samarthamp/Efficient_CLA_Adder/Magic/integrated_CLA_layout.spice

* SPICE3 file created from xor_v2_layout.ext - technology: scmos

.include TSMC_180nm.txt
.param vdd=1.8
.param LAMBDA=0.09u
.global vdd gnd
.option scale=0.09u

M1000 a_n100_n630# clk a_n100_n599# w_n113_n605# CMOSP w=40 l=2
+  ad=200 pd=90 as=320 ps=96
M1001 a_218_n321# clk a_196_n324# Gnd CMOSN w=20 l=2
+  ad=160 pd=56 as=100 ps=50
M1002 vdd a_205_n771# S2 w_225_n782# CMOSP w=20 l=2
+  ad=19200 pd=9170 as=100 ps=50
M1003 a_n44_n457# clk a_n44_n425# Gnd CMOSN w=20 l=2
+  ad=100 pd=50 as=160 ps=56
M1004 a_812_n333# a_754_n266# vdd w_743_n339# CMOSP w=20 l=2
+  ad=100 pd=50 as=0 ps=0
M1005 a_202_n456# A1_after vdd w_196_n469# CMOSP w=20 l=2
+  ad=100 pd=50 as=0 ps=0
M1006 a_576_n331# clk a_608_n304# w_569_n310# CMOSP w=40 l=2
+  ad=200 pd=90 as=320 ps=96
M1007 vdd a_290_n121# a_324_n129# w_318_n162# CMOSP w=40 l=2
+  ad=0 pd=0 as=320 ps=96
M1008 a_527_n409# Pout_bar a_556_n409# w_550_n422# CMOSP w=40 l=2
+  ad=200 pd=90 as=320 ps=96
M1009 vdd a_274_n792# a_262_n749# w_294_n803# CMOSP w=20 l=2
+  ad=0 pd=0 as=100 ps=50
M1010 a_n44_n599# a_n102_n532# vdd w_n113_n605# CMOSP w=20 l=2
+  ad=100 pd=50 as=0 ps=0
M1011 a_756_n364# Cout_before gnd Gnd CMOSN w=10 l=2
+  ad=60 pd=32 as=9600 ps=5350
M1012 vdd node14 a_184_n576# w_182_n587# CMOSP w=20 l=2
+  ad=0 pd=0 as=160 ps=56
M1013 gnd a_290_n121# a_293_n127# Gnd CMOSN w=10 l=2
+  ad=0 pd=0 as=60 ps=32
M1014 A1_after a_n37_n555# gnd Gnd CMOSN w=10 l=2
+  ad=50 pd=30 as=0 ps=0
M1015 a_511_n699# node23 vdd w_498_n705# CMOSP w=40 l=2
+  ad=320 pd=96 as=0 ps=0
M1016 a_39_n411# C0 gnd Gnd CMOSN w=10 l=2
+  ad=60 pd=32 as=0 ps=0
M1017 a_n106_n504# a_n100_n416# gnd Gnd CMOSN w=10 l=2
+  ad=60 pd=32 as=0 ps=0
M1018 vdd Gout_bar Cout_before w_616_n382# CMOSP w=20 l=2
+  ad=0 pd=0 as=160 ps=56
M1019 gnd a_797_n461# a_789_n425# Gnd CMOSN w=20 l=2
+  ad=0 pd=0 as=160 ps=56
M1020 a_202_n391# node11 gnd Gnd CMOSN w=10 l=2
+  ad=100 pd=60 as=0 ps=0
M1021 gnd A2_after P2_bar Gnd CMOSN w=10 l=2
+  ad=0 pd=0 as=80 ps=36
M1022 a_n102_n532# a_n106_n534# gnd Gnd CMOSN w=10 l=2
+  ad=50 pd=30 as=0 ps=0
M1023 gnd S1_before a_256_n323# Gnd CMOSN w=10 l=2
+  ad=0 pd=0 as=60 ps=32
M1024 node32 a_622_n503# gnd Gnd CMOSN w=10 l=2
+  ad=50 pd=30 as=0 ps=0
M1025 a_356_n893# a_322_n895# vdd w_350_n932# CMOSP w=40 l=2
+  ad=320 pd=96 as=0 ps=0
M1026 node32 a_622_n503# vdd w_616_n526# CMOSP w=20 l=2
+  ad=100 pd=50 as=0 ps=0
M1027 A3_after a_770_n555# vdd w_790_n566# CMOSP w=20 l=2
+  ad=200 pd=100 as=0 ps=0
M1028 a_842_n365# a_812_n333# gnd Gnd CMOSN w=20 l=2
+  ad=160 pd=56 as=0 ps=0
M1029 C1 node02 vdd w_331_n318# CMOSP w=20 l=2
+  ad=260 pd=106 as=0 ps=0
M1030 a_536_n460# node34 vdd w_570_n483# CMOSP w=20 l=2
+  ad=160 pd=56 as=0 ps=0
M1031 a_691_n653# a_633_n586# vdd w_622_n659# CMOSP w=20 l=2
+  ad=100 pd=50 as=0 ps=0
M1032 a_662_n369# node36 gnd Gnd CMOSN w=20 l=2
+  ad=160 pd=56 as=0 ps=0
M1033 a_635_n653# S3_before vdd w_622_n659# CMOSP w=40 l=2
+  ad=320 pd=96 as=0 ps=0
M1034 gnd P2_bar node24 Gnd CMOSN w=10 l=2
+  ad=0 pd=0 as=80 ps=36
M1035 a_n100_n477# B1 vdd w_n113_n483# CMOSP w=40 l=2
+  ad=320 pd=96 as=0 ps=0
M1036 vdd a_93_n615# C2 w_116_n646# CMOSP w=20 l=2
+  ad=0 pd=0 as=200 ps=100
M1037 vdd G3_bar node33 w_616_n467# CMOSP w=20 l=2
+  ad=0 pd=0 as=160 ps=56
M1038 a_122_n615# node15 a_93_n615# w_116_n646# CMOSP w=40 l=2
+  ad=320 pd=96 as=200 ps=90
M1039 vdd a_289_n151# a_289_n181# w_318_n162# CMOSP w=20 l=2
+  ad=0 pd=0 as=100 ps=50
M1040 a_292_n159# clk a_289_n181# Gnd CMOSN w=20 l=2
+  ad=160 pd=56 as=100 ps=50
M1041 node13 G1_bar vdd w_136_n587# CMOSP w=20 l=2
+  ad=160 pd=56 as=0 ps=0
M1042 G1_bar B1_after a_55_n540# Gnd CMOSN w=20 l=2
+  ad=100 pd=50 as=160 ps=56
M1043 gnd node01 a_326_n523# Gnd CMOSN w=10 l=2
+  ad=0 pd=0 as=100 ps=60
M1044 a_638_n284# a_580_n336# vdd w_569_n310# CMOSP w=20 l=2
+  ad=100 pd=50 as=0 ps=0
M1045 a_886_n355# Cout vdd w_873_n339# CMOSP w=20 l=2
+  ad=100 pd=50 as=0 ps=0
M1046 vdd a_93_n515# node12 w_116_n546# CMOSP w=20 l=2
+  ad=0 pd=0 as=100 ps=50
M1047 a_411_n699# P2_bar vdd w_398_n705# CMOSP w=40 l=2
+  ad=320 pd=96 as=0 ps=0
M1048 a_122_n515# G0_bar a_93_n515# w_116_n546# CMOSP w=40 l=2
+  ad=320 pd=96 as=200 ps=90
M1049 a_102_n336# a_95_n380# vdd w_112_n386# CMOSP w=20 l=2
+  ad=100 pd=50 as=0 ps=0
M1050 gnd a_415_n135# a_499_n159# Gnd CMOSN w=20 l=2
+  ad=0 pd=0 as=160 ps=56
M1051 a_662_n454# node32 gnd Gnd CMOSN w=20 l=2
+  ad=160 pd=56 as=0 ps=0
M1052 B2_after a_324_n823# vdd w_389_n858# CMOSP w=20 l=2
+  ad=200 pd=100 as=0 ps=0
M1053 vdd a_n106_n504# a_n102_n509# w_n108_n515# CMOSP w=20 l=2
+  ad=0 pd=0 as=100 ps=50
M1054 vdd a_415_n135# a_463_n181# w_441_n146# CMOSP w=20 l=2
+  ad=0 pd=0 as=100 ps=50
M1055 a_789_n631# clk a_770_n555# Gnd CMOSN w=20 l=2
+  ad=160 pd=56 as=100 ps=50
M1056 a_475_n895# A2 gnd Gnd CMOSN w=10 l=2
+  ad=60 pd=32 as=0 ps=0
M1057 a_39_n380# C0 vdd w_26_n386# CMOSP w=40 l=2
+  ad=320 pd=96 as=0 ps=0
M1058 gnd node21 a_183_n634# Gnd CMOSN w=10 l=2
+  ad=0 pd=0 as=100 ps=60
M1059 a_712_n284# S0 gnd Gnd CMOSN w=10 l=2
+  ad=50 pd=30 as=0 ps=0
M1060 a_557_n513# P2_bar vdd w_551_n526# CMOSP w=40 l=2
+  ad=320 pd=96 as=0 ps=0
M1061 a_344_n352# node02 C1 Gnd CMOSN w=20 l=2
+  ad=160 pd=56 as=150 ps=80
M1062 gnd a_196_n324# a_188_n321# Gnd CMOSN w=20 l=2
+  ad=0 pd=0 as=160 ps=56
M1063 a_274_n289# clk a_256_n323# w_215_n295# CMOSP w=40 l=2
+  ad=320 pd=96 as=200 ps=90
M1064 node21 C2 S2_before w_205_n645# CMOSP w=20 l=2
+  ad=300 pd=150 as=200 ps=100
M1065 a_875_n477# clk a_857_n480# w_816_n463# CMOSP w=40 l=2
+  ad=320 pd=96 as=200 ps=90
M1066 a_750_n268# clk a_782_n333# w_743_n339# CMOSP w=40 l=2
+  ad=200 pd=90 as=320 ps=96
M1067 S2_before a_183_n634# C2 Gnd CMOSN w=10 l=2
+  ad=100 pd=60 as=100 ps=60
M1068 vdd a_289_n181# a_292_n196# w_318_n192# CMOSP w=20 l=2
+  ad=0 pd=0 as=100 ps=50
M1069 a_292_n189# clk a_292_n196# Gnd CMOSN w=20 l=2
+  ad=160 pd=56 as=100 ps=50
M1070 C0_after a_102_n336# gnd Gnd CMOSN w=10 l=2
+  ad=100 pd=60 as=0 ps=0
M1071 Pout_bar node14 vdd w_440_n519# CMOSP w=20 l=2
+  ad=160 pd=56 as=0 ps=0
M1072 a_187_n515# P1_bar node14 w_181_n528# CMOSP w=40 l=2
+  ad=320 pd=96 as=200 ps=90
M1073 node35 a_536_n460# gnd Gnd CMOSN w=10 l=2
+  ad=50 pd=30 as=0 ps=0
M1074 vdd a_226_n324# a_196_n324# w_215_n295# CMOSP w=20 l=2
+  ad=0 pd=0 as=100 ps=50
M1075 S0_before node01 C0_after w_319_n502# CMOSP w=20 l=2
+  ad=200 pd=100 as=200 ps=100
M1076 a_635_n684# S3_before gnd Gnd CMOSN w=10 l=2
+  ad=60 pd=32 as=0 ps=0
M1077 C0_after a_102_n336# vdd w_100_n347# CMOSP w=20 l=2
+  ad=0 pd=0 as=0 ps=0
M1078 vdd A3_after a_496_n536# w_508_n640# CMOSP w=20 l=2
+  ad=0 pd=0 as=100 ps=50
M1079 gnd node13 a_93_n615# Gnd CMOSN w=10 l=2
+  ad=0 pd=0 as=80 ps=36
M1080 vdd a_857_n633# a_849_n599# w_816_n605# CMOSP w=40 l=2
+  ad=0 pd=0 as=320 ps=96
M1081 vdd a_441_n208# B0_after w_430_n188# CMOSP w=20 l=2
+  ad=0 pd=0 as=200 ps=100
M1082 a_226_n324# a_238_n224# vdd w_258_n235# CMOSP w=20 l=2
+  ad=100 pd=50 as=0 ps=0
M1083 vdd a_797_n461# a_770_n483# w_786_n463# CMOSP w=20 l=2
+  ad=0 pd=0 as=100 ps=50
M1084 a_451_n925# clk a_478_n893# w_472_n932# CMOSP w=40 l=2
+  ad=200 pd=90 as=320 ps=96
M1085 gnd a_770_n483# B3_after Gnd CMOSN w=10 l=2
+  ad=0 pd=0 as=100 ps=60
M1086 vdd a_576_n331# a_580_n336# w_574_n342# CMOSP w=20 l=2
+  ad=0 pd=0 as=100 ps=50
M1087 gnd a_463_n181# a_499_n189# Gnd CMOSN w=20 l=2
+  ad=0 pd=0 as=160 ps=56
M1088 a_454_n593# node24 gnd Gnd CMOSN w=20 l=2
+  ad=160 pd=56 as=0 ps=0
M1089 a_95_n380# clk a_95_n412# Gnd CMOSN w=20 l=2
+  ad=100 pd=50 as=160 ps=56
M1090 a_582_n304# S0_before vdd w_569_n310# CMOSP w=40 l=2
+  ad=320 pd=96 as=0 ps=0
M1091 a_n102_n532# a_n106_n534# vdd w_n108_n545# CMOSP w=20 l=2
+  ad=100 pd=50 as=0 ps=0
M1092 a_886_n355# Cout gnd Gnd CMOSN w=10 l=2
+  ad=50 pd=30 as=0 ps=0
M1093 vdd a_463_n181# a_441_n208# w_461_n192# CMOSP w=20 l=2
+  ad=0 pd=0 as=100 ps=50
M1094 gnd P3_bar node34 Gnd CMOSN w=10 l=2
+  ad=0 pd=0 as=80 ps=36
M1095 gnd P1_bar a_93_n515# Gnd CMOSN w=10 l=2
+  ad=0 pd=0 as=80 ps=36
M1096 a_698_n609# clk a_721_n685# Gnd CMOSN w=20 l=2
+  ad=100 pd=50 as=160 ps=56
M1097 B2_after a_324_n823# gnd Gnd CMOSN w=10 l=2
+  ad=50 pd=30 as=0 ps=0
M1098 a_668_n252# a_638_n284# gnd Gnd CMOSN w=20 l=2
+  ad=160 pd=56 as=0 ps=0
M1099 a_478_n919# A2 vdd w_472_n932# CMOSP w=40 l=2
+  ad=320 pd=96 as=0 ps=0
M1100 a_447_n129# clk a_420_n139# w_441_n146# CMOSP w=40 l=2
+  ad=320 pd=96 as=200 ps=90
M1101 a_343_n766# B2_after vdd w_337_n779# CMOSP w=40 l=2
+  ad=320 pd=96 as=0 ps=0
M1102 node01 C0_after S0_before w_319_n502# CMOSP w=20 l=2
+  ad=300 pd=150 as=0 ps=0
M1103 C3 node31 S3_before w_565_n707# CMOSP w=20 l=2
+  ad=200 pd=100 as=200 ps=100
M1104 node31 a_496_n536# B3_after Gnd CMOSN w=10 l=2
+  ad=100 pd=60 as=0 ps=0
M1105 a_472_n856# a_494_n835# vdd w_492_n846# CMOSP w=20 l=2
+  ad=100 pd=50 as=0 ps=0
M1106 gnd a_839_n504# a_827_n461# Gnd CMOSN w=10 l=2
+  ad=0 pd=0 as=50 ps=30
M1107 a_608_n304# a_582_n243# vdd w_569_n310# CMOSP w=40 l=2
+  ad=0 pd=0 as=0 ps=0
M1108 G2_bar B2_after a_423_n766# Gnd CMOSN w=20 l=2
+  ad=100 pd=50 as=160 ps=56
M1109 a_765_n675# S3 vdd w_752_n659# CMOSP w=20 l=2
+  ad=100 pd=50 as=0 ps=0
M1110 gnd a_232_n749# a_224_n713# Gnd CMOSN w=20 l=2
+  ad=0 pd=0 as=160 ps=56
M1111 node24 P2_bar a_411_n634# w_398_n640# CMOSP w=40 l=2
+  ad=200 pd=90 as=320 ps=96
M1112 a_n100_n416# clk a_n100_n477# w_n113_n483# CMOSP w=40 l=2
+  ad=200 pd=90 as=0 ps=0
M1113 gnd A0 a_290_n121# Gnd CMOSN w=10 l=2
+  ad=0 pd=0 as=60 ps=32
M1114 node25 a_454_n633# gnd Gnd CMOSN w=10 l=2
+  ad=50 pd=30 as=0 ps=0
M1115 A2_after a_266_n637# node21 Gnd CMOSN w=10 l=2
+  ad=100 pd=60 as=100 ps=60
M1116 a_819_n289# a_812_n333# vdd w_829_n339# CMOSP w=20 l=2
+  ad=100 pd=50 as=0 ps=0
M1117 a_622_n513# P3_bar vdd w_616_n526# CMOSP w=40 l=2
+  ad=320 pd=96 as=0 ps=0
M1118 A2_after B2_after node21 w_315_n650# CMOSP w=20 l=2
+  ad=200 pd=100 as=0 ps=0
M1119 a_789_n425# clk a_770_n483# Gnd CMOSN w=20 l=2
+  ad=0 pd=0 as=100 ps=50
M1120 gnd B0_after a_453_n435# Gnd CMOSN w=10 l=2
+  ad=0 pd=0 as=100 ps=60
M1121 a_712_n284# S0 vdd w_699_n290# CMOSP w=20 l=2
+  ad=100 pd=50 as=0 ps=0
M1122 gnd a_645_n310# S0 Gnd CMOSN w=10 l=2
+  ad=0 pd=0 as=50 ps=30
M1123 a_266_n637# B2_after gnd Gnd CMOSN w=10 l=2
+  ad=100 pd=60 as=0 ps=0
M1124 a_n74_n599# a_n100_n630# vdd w_n113_n605# CMOSP w=40 l=2
+  ad=320 pd=96 as=0 ps=0
M1125 node11 B1_after a_202_n456# Gnd CMOSN w=10 l=2
+  ad=100 pd=60 as=100 ps=60
M1126 vdd a_797_n634# a_770_n555# w_786_n605# CMOSP w=20 l=2
+  ad=0 pd=0 as=100 ps=50
M1127 gnd A0_after a_383_n262# Gnd CMOSN w=20 l=2
+  ad=0 pd=0 as=160 ps=56
M1128 P0_bar A0_after gnd Gnd CMOSN w=10 l=2
+  ad=80 pd=36 as=0 ps=0
M1129 node11 B1_after A1_after w_251_n469# CMOSP w=20 l=2
+  ad=300 pd=150 as=200 ps=100
M1130 a_496_n536# B3_after node31 Gnd CMOSN w=10 l=2
+  ad=100 pd=60 as=0 ps=0
M1131 S0_before a_326_n523# C0_after Gnd CMOSN w=10 l=2
+  ad=100 pd=60 as=0 ps=0
M1132 vdd node01 a_326_n523# w_338_n447# CMOSP w=20 l=2
+  ad=0 pd=0 as=100 ps=50
M1133 gnd a_857_n633# a_839_n534# Gnd CMOSN w=10 l=2
+  ad=0 pd=0 as=60 ps=32
M1134 a_494_n835# a_446_n921# vdd w_472_n932# CMOSP w=20 l=2
+  ad=100 pd=50 as=0 ps=0
M1135 a_622_n413# node33 vdd w_616_n426# CMOSP w=40 l=2
+  ad=320 pd=96 as=0 ps=0
M1136 gnd a_441_n208# B0_after Gnd CMOSN w=10 l=2
+  ad=0 pd=0 as=50 ps=30
M1137 S1 a_169_n245# vdd w_189_n256# CMOSP w=20 l=2
+  ad=100 pd=50 as=0 ps=0
M1138 a_530_n833# a_494_n835# gnd Gnd CMOSN w=20 l=2
+  ad=160 pd=56 as=0 ps=0
M1139 node24 P1_bar gnd Gnd CMOSN w=10 l=2
+  ad=0 pd=0 as=0 ps=0
M1140 vdd a_184_n576# node15 w_182_n587# CMOSP w=20 l=2
+  ad=0 pd=0 as=100 ps=50
M1141 a_827_n634# a_839_n534# gnd Gnd CMOSN w=10 l=2
+  ad=50 pd=30 as=0 ps=0
M1142 gnd A1_after P1_bar Gnd CMOSN w=10 l=2
+  ad=0 pd=0 as=80 ps=36
M1143 C3 a_571_n723# S3_before Gnd CMOSN w=10 l=2
+  ad=100 pd=60 as=100 ps=60
M1144 vdd a_292_n768# a_284_n765# w_251_n751# CMOSP w=40 l=2
+  ad=0 pd=0 as=320 ps=96
M1145 a_55_n540# A1_after gnd Gnd CMOSN w=20 l=2
+  ad=0 pd=0 as=0 ps=0
M1146 gnd a_274_n792# a_262_n749# Gnd CMOSN w=10 l=2
+  ad=0 pd=0 as=50 ps=30
M1147 gnd B3_after P3_bar Gnd CMOSN w=10 l=2
+  ad=0 pd=0 as=80 ps=36
M1148 vdd G2_bar node23 w_457_n685# CMOSP w=20 l=2
+  ad=0 pd=0 as=160 ps=56
M1149 a_n14_n631# a_n44_n599# gnd Gnd CMOSN w=20 l=2
+  ad=160 pd=56 as=0 ps=0
M1150 gnd A3_after a_496_n536# Gnd CMOSN w=10 l=2
+  ad=0 pd=0 as=0 ps=0
M1151 gnd S2 a_183_n745# Gnd CMOSN w=10 l=2
+  ad=0 pd=0 as=50 ps=30
M1152 vdd a_n37_n483# B1_after w_n39_n494# CMOSP w=20 l=2
+  ad=0 pd=0 as=200 ps=100
M1153 a_202_n391# node11 vdd w_196_n404# CMOSP w=20 l=2
+  ad=100 pd=50 as=0 ps=0
M1154 a_765_n675# S3 gnd Gnd CMOSN w=10 l=2
+  ad=50 pd=30 as=0 ps=0
M1155 a_536_n470# node34 gnd Gnd CMOSN w=20 l=2
+  ad=160 pd=56 as=0 ps=0
M1156 a_325_n893# clk a_356_n893# w_350_n932# CMOSP w=40 l=2
+  ad=200 pd=90 as=0 ps=0
M1157 vdd A3_after G3_bar w_708_n466# CMOSP w=20 l=2
+  ad=0 pd=0 as=160 ps=56
M1158 a_645_n310# a_638_n284# vdd w_655_n290# CMOSP w=20 l=2
+  ad=100 pd=50 as=0 ps=0
M1159 a_33_n315# clk a_65_n380# w_26_n386# CMOSP w=40 l=2
+  ad=200 pd=90 as=320 ps=96
M1160 a_326_n523# C0_after S0_before Gnd CMOSN w=10 l=2
+  ad=0 pd=0 as=0 ps=0
M1161 vdd node13 a_536_n460# w_570_n483# CMOSP w=20 l=2
+  ad=0 pd=0 as=0 ps=0
M1162 node31 A3_after B3_after w_489_n585# CMOSP w=20 l=2
+  ad=300 pd=150 as=200 ps=100
M1163 node36 a_527_n409# gnd Gnd CMOSN w=10 l=2
+  ad=50 pd=30 as=0 ps=0
M1164 a_102_n574# G1_bar node13 Gnd CMOSN w=20 l=2
+  ad=160 pd=56 as=100 ps=50
M1165 Cout_before Gout_bar a_662_n369# Gnd CMOSN w=20 l=2
+  ad=100 pd=50 as=0 ps=0
M1166 vdd S2_before a_310_n765# w_251_n751# CMOSP w=40 l=2
+  ad=0 pd=0 as=320 ps=96
M1167 C0_bar C0_after vdd w_398_n507# CMOSP w=20 l=2
+  ad=100 pd=50 as=0 ps=0
M1168 gnd B3 a_857_n480# Gnd CMOSN w=10 l=2
+  ad=0 pd=0 as=60 ps=32
M1169 a_188_n321# clk a_169_n245# Gnd CMOSN w=20 l=2
+  ad=0 pd=0 as=100 ps=50
M1170 vdd node13 a_122_n615# w_116_n646# CMOSP w=40 l=2
+  ad=0 pd=0 as=0 ps=0
M1171 a_530_n863# a_446_n921# gnd Gnd CMOSN w=20 l=2
+  ad=160 pd=56 as=0 ps=0
M1172 a_782_n333# a_756_n364# vdd w_743_n339# CMOSP w=40 l=2
+  ad=0 pd=0 as=0 ps=0
M1173 gnd a_289_n151# a_292_n159# Gnd CMOSN w=20 l=2
+  ad=0 pd=0 as=0 ps=0
M1174 vdd node12 node13 w_136_n587# CMOSP w=20 l=2
+  ad=0 pd=0 as=0 ps=0
M1175 a_325_n893# a_322_n895# gnd Gnd CMOSN w=10 l=2
+  ad=60 pd=32 as=0 ps=0
M1176 a_228_n558# C0_after a_184_n576# Gnd CMOSN w=20 l=2
+  ad=160 pd=56 as=100 ps=50
M1177 vdd a_232_n749# a_205_n771# w_221_n751# CMOSP w=20 l=2
+  ad=0 pd=0 as=100 ps=50
M1178 a_356_n919# B2 vdd w_350_n932# CMOSP w=40 l=2
+  ad=320 pd=96 as=0 ps=0
M1179 a_324_n103# clk a_290_n121# w_318_n162# CMOSP w=40 l=2
+  ad=320 pd=96 as=200 ps=90
M1180 a_n37_n555# clk a_n14_n631# Gnd CMOSN w=20 l=2
+  ad=100 pd=50 as=0 ps=0
M1181 gnd a_184_n576# node15 Gnd CMOSN w=10 l=2
+  ad=0 pd=0 as=50 ps=30
M1182 node25 a_454_n633# vdd w_441_n639# CMOSP w=20 l=2
+  ad=100 pd=50 as=0 ps=0
M1183 a_849_n599# clk a_839_n534# w_816_n605# CMOSP w=40 l=2
+  ad=0 pd=0 as=200 ps=90
M1184 S3_before C3 node31 w_565_n707# CMOSP w=20 l=2
+  ad=0 pd=0 as=0 ps=0
M1185 vdd node34 Pout_bar w_440_n519# CMOSP w=20 l=2
+  ad=0 pd=0 as=0 ps=0
M1186 a_n106_n534# a_n100_n630# gnd Gnd CMOSN w=10 l=2
+  ad=60 pd=32 as=0 ps=0
M1187 vdd P1_bar a_122_n515# w_116_n546# CMOSP w=40 l=2
+  ad=0 pd=0 as=0 ps=0
M1188 node33 G3_bar a_662_n454# Gnd CMOSN w=20 l=2
+  ad=100 pd=50 as=0 ps=0
M1189 vdd a_256_n323# a_248_n289# w_215_n295# CMOSP w=40 l=2
+  ad=0 pd=0 as=320 ps=96
M1190 vdd node21 a_183_n634# w_260_n650# CMOSP w=20 l=2
+  ad=0 pd=0 as=100 ps=50
M1191 A3_after B3_after node31 w_489_n585# CMOSP w=20 l=2
+  ad=0 pd=0 as=0 ps=0
M1192 a_622_n503# P3_bar gnd Gnd CMOSN w=10 l=2
+  ad=80 pd=36 as=0 ps=0
M1193 gnd a_444_n121# a_420_n139# Gnd CMOSN w=10 l=2
+  ad=0 pd=0 as=60 ps=32
M1194 vdd a_857_n480# a_849_n477# w_816_n463# CMOSP w=40 l=2
+  ad=0 pd=0 as=320 ps=96
M1195 gnd A3_after a_721_n500# Gnd CMOSN w=20 l=2
+  ad=0 pd=0 as=160 ps=56
M1196 vdd C1 a_454_n633# w_441_n639# CMOSP w=20 l=2
+  ad=0 pd=0 as=160 ps=56
M1197 node34 P3_bar a_557_n513# w_551_n526# CMOSP w=40 l=2
+  ad=200 pd=90 as=0 ps=0
M1198 a_527_n409# C0_bar gnd Gnd CMOSN w=10 l=2
+  ad=80 pd=36 as=0 ps=0
M1199 A3_after a_770_n555# gnd Gnd CMOSN w=10 l=2
+  ad=50 pd=30 as=0 ps=0
M1200 a_721_n685# a_691_n653# gnd Gnd CMOSN w=20 l=2
+  ad=0 pd=0 as=0 ps=0
M1201 a_183_n634# C2 S2_before Gnd CMOSN w=10 l=2
+  ad=0 pd=0 as=0 ps=0
M1202 a_102_n336# clk a_125_n412# Gnd CMOSN w=20 l=2
+  ad=100 pd=50 as=160 ps=56
M1203 a_95_n412# a_37_n313# gnd Gnd CMOSN w=20 l=2
+  ad=0 pd=0 as=0 ps=0
M1204 gnd a_289_n181# a_292_n189# Gnd CMOSN w=20 l=2
+  ad=0 pd=0 as=0 ps=0
M1205 a_571_n723# node31 gnd Gnd CMOSN w=10 l=2
+  ad=100 pd=60 as=0 ps=0
M1206 node23 G2_bar a_470_n719# Gnd CMOSN w=20 l=2
+  ad=100 pd=50 as=160 ps=56
M1207 B0_after A0_after node01 w_446_n414# CMOSP w=20 l=2
+  ad=0 pd=0 as=0 ps=0
M1208 vdd P0_bar a_187_n515# w_181_n528# CMOSP w=40 l=2
+  ad=0 pd=0 as=0 ps=0
M1209 Gout_bar node33 gnd Gnd CMOSN w=10 l=2
+  ad=80 pd=36 as=0 ps=0
M1210 vdd a_383_n357# node02 w_372_n337# CMOSP w=20 l=2
+  ad=0 pd=0 as=100 ps=50
M1211 C0_bar C0_after gnd Gnd CMOSN w=10 l=2
+  ad=50 pd=30 as=0 ps=0
M1212 vdd S2 a_183_n745# w_177_n751# CMOSP w=20 l=2
+  ad=0 pd=0 as=100 ps=50
M1213 a_750_n268# a_756_n364# gnd Gnd CMOSN w=10 l=2
+  ad=60 pd=32 as=0 ps=0
M1214 gnd a_93_n615# C2 Gnd CMOSN w=10 l=2
+  ad=0 pd=0 as=0 ps=0
M1215 a_n14_n425# a_n44_n457# gnd Gnd CMOSN w=20 l=2
+  ad=160 pd=56 as=0 ps=0
M1216 gnd a_827_n634# a_819_n631# Gnd CMOSN w=20 l=2
+  ad=0 pd=0 as=160 ps=56
M1217 a_754_n266# a_750_n268# gnd Gnd CMOSN w=10 l=2
+  ad=50 pd=30 as=0 ps=0
M1218 vdd B0_after a_453_n435# w_465_n359# CMOSP w=20 l=2
+  ad=0 pd=0 as=100 ps=50
M1219 a_33_n315# a_39_n411# gnd Gnd CMOSN w=10 l=2
+  ad=60 pd=32 as=0 ps=0
M1220 a_754_n266# a_750_n268# vdd w_748_n279# CMOSP w=20 l=2
+  ad=100 pd=50 as=0 ps=0
M1221 a_224_n713# clk a_205_n771# Gnd CMOSN w=20 l=2
+  ad=0 pd=0 as=100 ps=50
M1222 a_411_n634# P1_bar vdd w_398_n640# CMOSP w=40 l=2
+  ad=0 pd=0 as=0 ps=0
M1223 Cout a_819_n289# gnd Gnd CMOSN w=10 l=2
+  ad=50 pd=30 as=0 ps=0
M1224 S3_before C3 a_571_n723# Gnd CMOSN w=10 l=2
+  ad=0 pd=0 as=0 ps=0
M1225 a_486_n506# node14 gnd Gnd CMOSN w=20 l=2
+  ad=160 pd=56 as=0 ps=0
M1226 Cout a_819_n289# vdd w_817_n300# CMOSP w=20 l=2
+  ad=100 pd=50 as=0 ps=0
M1227 a_37_n313# a_33_n315# gnd Gnd CMOSN w=10 l=2
+  ad=50 pd=30 as=0 ps=0
M1228 gnd a_93_n515# node12 Gnd CMOSN w=10 l=2
+  ad=0 pd=0 as=50 ps=30
M1229 a_37_n313# a_33_n315# vdd w_31_n326# CMOSP w=20 l=2
+  ad=100 pd=50 as=0 ps=0
M1230 gnd a_576_n331# a_580_n336# Gnd CMOSN w=10 l=2
+  ad=0 pd=0 as=50 ps=30
M1231 a_n106_n534# clk a_n74_n599# w_n113_n605# CMOSP w=40 l=2
+  ad=200 pd=90 as=0 ps=0
M1232 gnd a_262_n749# a_254_n713# Gnd CMOSN w=20 l=2
+  ad=0 pd=0 as=160 ps=56
M1233 a_475_n895# clk a_478_n919# w_472_n932# CMOSP w=40 l=2
+  ad=200 pd=90 as=0 ps=0
M1234 vdd B1_after G1_bar w_42_n586# CMOSP w=20 l=2
+  ad=0 pd=0 as=160 ps=56
M1235 a_321_n865# a_325_n893# vdd w_410_n927# CMOSP w=20 l=2
+  ad=100 pd=50 as=0 ps=0
M1236 gnd node25 a_511_n728# Gnd CMOSN w=10 l=2
+  ad=0 pd=0 as=80 ps=36
M1237 vdd A0 a_324_n103# w_318_n162# CMOSP w=40 l=2
+  ad=0 pd=0 as=0 ps=0
M1238 vdd a_444_n121# a_447_n129# w_441_n146# CMOSP w=40 l=2
+  ad=0 pd=0 as=0 ps=0
M1239 P2_bar A2_after a_343_n766# w_337_n779# CMOSP w=40 l=2
+  ad=200 pd=90 as=0 ps=0
M1240 a_812_n333# clk a_812_n365# Gnd CMOSN w=20 l=2
+  ad=100 pd=50 as=160 ps=56
M1241 vdd a_645_n310# S0 w_643_n321# CMOSP w=20 l=2
+  ad=0 pd=0 as=100 ps=50
M1242 a_443_n262# A0_after P0_bar w_437_n275# CMOSP w=40 l=2
+  ad=320 pd=96 as=200 ps=90
M1243 a_324_n833# a_321_n835# gnd Gnd CMOSN w=20 l=2
+  ad=160 pd=56 as=0 ps=0
M1244 a_629_n588# clk a_661_n653# w_622_n659# CMOSP w=40 l=2
+  ad=200 pd=90 as=320 ps=96
M1245 a_n74_n477# a_n100_n416# vdd w_n113_n483# CMOSP w=40 l=2
+  ad=320 pd=96 as=0 ps=0
M1246 a_n37_n483# clk a_n14_n425# Gnd CMOSN w=20 l=2
+  ad=100 pd=50 as=0 ps=0
M1247 vdd a_196_n324# a_169_n245# w_185_n295# CMOSP w=20 l=2
+  ad=0 pd=0 as=100 ps=50
M1248 a_n100_n416# B1 gnd Gnd CMOSN w=10 l=2
+  ad=60 pd=32 as=0 ps=0
M1249 a_453_n435# A0_after node01 Gnd CMOSN w=10 l=2
+  ad=0 pd=0 as=100 ps=60
M1250 P1_bar B1_after gnd Gnd CMOSN w=10 l=2
+  ad=0 pd=0 as=0 ps=0
M1251 gnd a_383_n357# node02 Gnd CMOSN w=10 l=2
+  ad=0 pd=0 as=50 ps=30
M1252 a_284_n765# clk a_274_n792# w_251_n751# CMOSP w=40 l=2
+  ad=0 pd=0 as=200 ps=90
M1253 P1_bar A1_after a_55_n480# w_42_n486# CMOSP w=40 l=2
+  ad=200 pd=90 as=320 ps=96
M1254 gnd a_256_n323# a_238_n224# Gnd CMOSN w=10 l=2
+  ad=0 pd=0 as=60 ps=32
M1255 P3_bar A3_after gnd Gnd CMOSN w=10 l=2
+  ad=0 pd=0 as=0 ps=0
M1256 node23 node22 vdd w_457_n685# CMOSP w=20 l=2
+  ad=0 pd=0 as=0 ps=0
M1257 a_226_n324# a_238_n224# gnd Gnd CMOSN w=10 l=2
+  ad=50 pd=30 as=0 ps=0
M1258 a_321_n865# a_325_n893# gnd Gnd CMOSN w=10 l=2
+  ad=50 pd=30 as=0 ps=0
M1259 a_622_n503# G2_bar a_622_n513# w_616_n526# CMOSP w=40 l=2
+  ad=200 pd=90 as=0 ps=0
M1260 a_266_n637# B2_after vdd w_260_n650# CMOSP w=20 l=2
+  ad=100 pd=50 as=0 ps=0
M1261 G3_bar B3_after vdd w_708_n466# CMOSP w=20 l=2
+  ad=0 pd=0 as=0 ps=0
M1262 B1_after a_202_n456# node11 Gnd CMOSN w=10 l=2
+  ad=100 pd=60 as=0 ps=0
M1263 a_65_n380# a_39_n411# vdd w_26_n386# CMOSP w=40 l=2
+  ad=0 pd=0 as=0 ps=0
M1264 gnd B0_after P0_bar Gnd CMOSN w=10 l=2
+  ad=0 pd=0 as=0 ps=0
M1265 a_691_n653# clk a_691_n685# Gnd CMOSN w=20 l=2
+  ad=100 pd=50 as=160 ps=56
M1266 a_n44_n631# a_n102_n532# gnd Gnd CMOSN w=20 l=2
+  ad=160 pd=56 as=0 ps=0
M1267 B1_after A1_after node11 w_251_n469# CMOSP w=20 l=2
+  ad=0 pd=0 as=0 ps=0
M1268 A1_after a_n37_n555# vdd w_n39_n566# CMOSP w=20 l=2
+  ad=0 pd=0 as=0 ps=0
M1269 Gout_bar node35 a_622_n413# w_616_n426# CMOSP w=40 l=2
+  ad=200 pd=90 as=0 ps=0
M1270 a_324_n863# a_321_n865# gnd Gnd CMOSN w=20 l=2
+  ad=160 pd=56 as=0 ps=0
M1271 gnd S1 a_147_n311# Gnd CMOSN w=10 l=2
+  ad=0 pd=0 as=50 ps=30
M1272 S1_before C1 a_202_n391# Gnd CMOSN w=10 l=2
+  ad=100 pd=60 as=0 ps=0
M1273 gnd C0_bar a_383_n357# Gnd CMOSN w=10 l=2
+  ad=0 pd=0 as=80 ps=36
M1274 a_582_n243# S0_before gnd Gnd CMOSN w=10 l=2
+  ad=60 pd=32 as=0 ps=0
M1275 a_310_n765# clk a_292_n768# w_251_n751# CMOSP w=40 l=2
+  ad=0 pd=0 as=200 ps=90
M1276 gnd G1_bar a_411_n728# Gnd CMOSN w=10 l=2
+  ad=0 pd=0 as=80 ps=36
M1277 a_472_n856# clk a_530_n833# Gnd CMOSN w=20 l=2
+  ad=100 pd=50 as=0 ps=0
M1278 a_n37_n483# a_n44_n457# vdd w_n27_n463# CMOSP w=20 l=2
+  ad=100 pd=50 as=0 ps=0
M1279 S1_before C1 node11 w_251_n404# CMOSP w=20 l=2
+  ad=200 pd=100 as=0 ps=0
M1280 G0_bar B0_after vdd w_337_n275# CMOSP w=20 l=2
+  ad=160 pd=56 as=0 ps=0
M1281 vdd A3 a_875_n599# w_816_n605# CMOSP w=40 l=2
+  ad=0 pd=0 as=320 ps=96
M1282 gnd a_827_n461# a_819_n425# Gnd CMOSN w=20 l=2
+  ad=0 pd=0 as=160 ps=56
M1283 a_633_n586# a_629_n588# gnd Gnd CMOSN w=10 l=2
+  ad=50 pd=30 as=0 ps=0
M1284 G2_bar A2_after vdd w_457_n779# CMOSP w=20 l=2
+  ad=160 pd=56 as=0 ps=0
M1285 a_633_n586# a_629_n588# vdd w_627_n599# CMOSP w=20 l=2
+  ad=100 pd=50 as=0 ps=0
M1286 gnd a_205_n771# S2 Gnd CMOSN w=10 l=2
+  ad=0 pd=0 as=50 ps=30
M1287 node01 B0_after A0_after w_446_n414# CMOSP w=20 l=2
+  ad=0 pd=0 as=200 ps=100
M1288 a_536_n460# node13 a_536_n470# Gnd CMOSN w=20 l=2
+  ad=100 pd=50 as=0 ps=0
M1289 node14 P1_bar gnd Gnd CMOSN w=10 l=2
+  ad=80 pd=36 as=0 ps=0
M1290 vdd a_262_n749# a_232_n749# w_251_n751# CMOSP w=20 l=2
+  ad=0 pd=0 as=100 ps=50
M1291 a_698_n609# a_691_n653# vdd w_708_n659# CMOSP w=20 l=2
+  ad=100 pd=50 as=0 ps=0
M1292 a_248_n289# clk a_238_n224# w_215_n295# CMOSP w=40 l=2
+  ad=0 pd=0 as=200 ps=90
M1293 a_576_n331# a_582_n243# gnd Gnd CMOSN w=10 l=2
+  ad=60 pd=32 as=0 ps=0
M1294 a_849_n477# clk a_839_n504# w_816_n463# CMOSP w=40 l=2
+  ad=0 pd=0 as=200 ps=90
M1295 a_756_n364# clk a_756_n333# w_743_n339# CMOSP w=40 l=2
+  ad=200 pd=90 as=320 ps=96
M1296 vdd C0_bar a_403_n331# w_372_n337# CMOSP w=40 l=2
+  ad=0 pd=0 as=320 ps=96
M1297 A0_after a_292_n196# vdd w_357_n188# CMOSP w=20 l=2
+  ad=0 pd=0 as=0 ps=0
M1298 a_571_n723# node31 vdd w_565_n652# CMOSP w=20 l=2
+  ad=100 pd=50 as=0 ps=0
M1299 gnd node12 a_102_n574# Gnd CMOSN w=20 l=2
+  ad=0 pd=0 as=0 ps=0
M1300 a_721_n500# B3_after G3_bar Gnd CMOSN w=20 l=2
+  ad=0 pd=0 as=100 ps=50
M1301 a_454_n633# node24 vdd w_441_n639# CMOSP w=20 l=2
+  ad=0 pd=0 as=0 ps=0
M1302 a_494_n835# clk a_530_n863# Gnd CMOSN w=20 l=2
+  ad=100 pd=50 as=0 ps=0
M1303 a_202_n456# A1_after gnd Gnd CMOSN w=10 l=2
+  ad=0 pd=0 as=0 ps=0
M1304 a_324_n129# clk a_293_n127# w_318_n162# CMOSP w=40 l=2
+  ad=0 pd=0 as=200 ps=90
M1305 a_556_n409# C0_bar vdd w_550_n422# CMOSP w=40 l=2
+  ad=0 pd=0 as=0 ps=0
M1306 vdd B3_after a_721_n580# w_708_n586# CMOSP w=40 l=2
+  ad=0 pd=0 as=320 ps=96
M1307 gnd node14 a_228_n558# Gnd CMOSN w=20 l=2
+  ad=0 pd=0 as=0 ps=0
M1308 a_322_n895# clk a_356_n919# w_350_n932# CMOSP w=40 l=2
+  ad=200 pd=90 as=0 ps=0
M1309 a_125_n412# a_95_n380# gnd Gnd CMOSN w=20 l=2
+  ad=0 pd=0 as=0 ps=0
M1310 a_638_n284# clk a_638_n252# Gnd CMOSN w=20 l=2
+  ad=100 pd=50 as=160 ps=56
M1311 S3 a_698_n609# gnd Gnd CMOSN w=10 l=2
+  ad=50 pd=30 as=0 ps=0
M1312 a_184_n576# C0_after vdd w_182_n587# CMOSP w=20 l=2
+  ad=0 pd=0 as=0 ps=0
M1313 a_470_n719# node22 gnd Gnd CMOSN w=20 l=2
+  ad=0 pd=0 as=0 ps=0
M1314 S3 a_698_n609# vdd w_696_n620# CMOSP w=20 l=2
+  ad=100 pd=50 as=0 ps=0
M1315 S1 a_169_n245# gnd Gnd CMOSN w=10 l=2
+  ad=50 pd=30 as=0 ps=0
M1316 vdd S1 a_147_n311# w_141_n295# CMOSP w=20 l=2
+  ad=0 pd=0 as=100 ps=50
M1317 Cout_before node36 vdd w_616_n382# CMOSP w=20 l=2
+  ad=0 pd=0 as=0 ps=0
M1318 P2_bar B2_after gnd Gnd CMOSN w=10 l=2
+  ad=0 pd=0 as=0 ps=0
M1319 a_819_n631# clk a_797_n634# Gnd CMOSN w=20 l=2
+  ad=0 pd=0 as=100 ps=50
M1320 a_n37_n555# a_n44_n599# vdd w_n27_n605# CMOSP w=20 l=2
+  ad=100 pd=50 as=0 ps=0
M1321 gnd G2_bar a_622_n503# Gnd CMOSN w=10 l=2
+  ad=0 pd=0 as=0 ps=0
M1322 gnd a_n37_n483# B1_after Gnd CMOSN w=10 l=2
+  ad=0 pd=0 as=0 ps=0
M1323 node01 a_453_n435# A0_after Gnd CMOSN w=10 l=2
+  ad=0 pd=0 as=100 ps=60
M1324 a_322_n895# B2 gnd Gnd CMOSN w=10 l=2
+  ad=60 pd=32 as=0 ps=0
M1325 a_289_n151# a_293_n127# vdd w_378_n119# CMOSP w=20 l=2
+  ad=100 pd=50 as=0 ps=0
M1326 gnd a_226_n324# a_218_n321# Gnd CMOSN w=20 l=2
+  ad=0 pd=0 as=0 ps=0
M1327 node35 a_536_n460# vdd w_570_n483# CMOSP w=20 l=2
+  ad=100 pd=50 as=0 ps=0
M1328 a_n44_n425# a_n102_n509# gnd Gnd CMOSN w=20 l=2
+  ad=0 pd=0 as=0 ps=0
M1329 gnd Pout_bar a_527_n409# Gnd CMOSN w=10 l=2
+  ad=0 pd=0 as=0 ps=0
M1330 Pout_bar node34 a_486_n506# Gnd CMOSN w=20 l=2
+  ad=100 pd=50 as=0 ps=0
M1331 node33 node32 vdd w_616_n467# CMOSP w=20 l=2
+  ad=0 pd=0 as=0 ps=0
M1332 a_254_n713# clk a_232_n749# Gnd CMOSN w=20 l=2
+  ad=0 pd=0 as=100 ps=50
M1333 G1_bar A1_after vdd w_42_n586# CMOSP w=20 l=2
+  ad=0 pd=0 as=0 ps=0
M1334 a_451_n925# a_475_n895# gnd Gnd CMOSN w=10 l=2
+  ad=60 pd=32 as=0 ps=0
M1335 vdd a_770_n483# B3_after w_790_n494# CMOSP w=20 l=2
+  ad=0 pd=0 as=0 ps=0
M1336 gnd A3 a_857_n633# Gnd CMOSN w=10 l=2
+  ad=0 pd=0 as=60 ps=32
M1337 a_511_n728# node23 gnd Gnd CMOSN w=10 l=2
+  ad=0 pd=0 as=0 ps=0
M1338 gnd node35 Gout_bar Gnd CMOSN w=10 l=2
+  ad=0 pd=0 as=0 ps=0
M1339 a_511_n728# node25 a_511_n699# w_498_n705# CMOSP w=40 l=2
+  ad=200 pd=90 as=0 ps=0
M1340 a_812_n365# a_754_n266# gnd Gnd CMOSN w=20 l=2
+  ad=0 pd=0 as=0 ps=0
M1341 vdd a_827_n461# a_797_n461# w_816_n463# CMOSP w=20 l=2
+  ad=0 pd=0 as=100 ps=50
M1342 C3 a_511_n728# gnd Gnd CMOSN w=10 l=2
+  ad=0 pd=0 as=0 ps=0
M1343 a_661_n653# a_635_n684# vdd w_622_n659# CMOSP w=40 l=2
+  ad=0 pd=0 as=0 ps=0
M1344 a_n106_n504# clk a_n74_n477# w_n113_n483# CMOSP w=40 l=2
+  ad=200 pd=90 as=0 ps=0
M1345 gnd a_292_n768# a_274_n792# Gnd CMOSN w=10 l=2
+  ad=0 pd=0 as=60 ps=32
M1346 vdd a_451_n925# a_446_n921# w_440_n927# CMOSP w=20 l=2
+  ad=0 pd=0 as=100 ps=50
M1347 a_55_n480# B1_after vdd w_42_n486# CMOSP w=40 l=2
+  ad=0 pd=0 as=0 ps=0
M1348 a_499_n159# clk a_463_n181# Gnd CMOSN w=20 l=2
+  ad=0 pd=0 as=100 ps=50
M1349 a_n100_n599# A1 vdd w_n113_n605# CMOSP w=40 l=2
+  ad=0 pd=0 as=0 ps=0
M1350 vdd G0_bar C1 w_331_n318# CMOSP w=20 l=2
+  ad=0 pd=0 as=0 ps=0
M1351 vdd a_420_n139# a_415_n135# w_409_n119# CMOSP w=20 l=2
+  ad=0 pd=0 as=100 ps=50
M1352 a_819_n289# clk a_842_n365# Gnd CMOSN w=20 l=2
+  ad=100 pd=50 as=0 ps=0
M1353 vdd a_472_n856# A2_after w_461_n858# CMOSP w=20 l=2
+  ad=0 pd=0 as=0 ps=0
M1354 A0_after a_292_n196# gnd Gnd CMOSN w=10 l=2
+  ad=0 pd=0 as=0 ps=0
M1355 a_635_n684# clk a_635_n653# w_622_n659# CMOSP w=40 l=2
+  ad=200 pd=90 as=0 ps=0
M1356 S2_before node21 C2 w_205_n645# CMOSP w=20 l=2
+  ad=0 pd=0 as=0 ps=0
M1357 vdd a_839_n504# a_827_n461# w_859_n515# CMOSP w=20 l=2
+  ad=0 pd=0 as=100 ps=50
M1358 a_289_n151# a_293_n127# gnd Gnd CMOSN w=10 l=2
+  ad=50 pd=30 as=0 ps=0
M1359 a_691_n685# a_633_n586# gnd Gnd CMOSN w=20 l=2
+  ad=0 pd=0 as=0 ps=0
M1360 a_n44_n599# clk a_n44_n631# Gnd CMOSN w=20 l=2
+  ad=100 pd=50 as=0 ps=0
M1361 vdd B0_after a_443_n262# w_437_n275# CMOSP w=40 l=2
+  ad=0 pd=0 as=0 ps=0
M1362 gnd a_451_n925# a_446_n921# Gnd CMOSN w=10 l=2
+  ad=0 pd=0 as=50 ps=30
M1363 a_324_n823# clk a_324_n833# Gnd CMOSN w=20 l=2
+  ad=100 pd=50 as=0 ps=0
M1364 a_93_n615# node15 gnd Gnd CMOSN w=10 l=2
+  ad=0 pd=0 as=0 ps=0
M1365 gnd S2_before a_292_n768# Gnd CMOSN w=10 l=2
+  ad=0 pd=0 as=60 ps=32
M1366 a_383_n357# P0_bar gnd Gnd CMOSN w=10 l=2
+  ad=0 pd=0 as=0 ps=0
M1367 a_411_n728# P2_bar gnd Gnd CMOSN w=10 l=2
+  ad=0 pd=0 as=0 ps=0
M1368 a_478_n893# a_475_n895# vdd w_472_n932# CMOSP w=40 l=2
+  ad=0 pd=0 as=0 ps=0
M1369 a_95_n380# a_37_n313# vdd w_26_n386# CMOSP w=20 l=2
+  ad=100 pd=50 as=0 ps=0
M1370 a_411_n728# G1_bar a_411_n699# w_398_n705# CMOSP w=40 l=2
+  ad=200 pd=90 as=0 ps=0
M1371 gnd a_797_n634# a_789_n631# Gnd CMOSN w=20 l=2
+  ad=0 pd=0 as=0 ps=0
M1372 a_875_n599# clk a_857_n633# w_816_n605# CMOSP w=40 l=2
+  ad=0 pd=0 as=200 ps=90
M1373 a_499_n189# clk a_441_n208# Gnd CMOSN w=20 l=2
+  ad=0 pd=0 as=100 ps=50
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
