samarthamp/Efficient_CLA_Adder/Vivado/constraints_cla.xdc

# clk input is from the 100 MHz oscillator on Boolean board
#create_clock -period 10.000 -name gclk [get_ports clk_100MHz]
#set_property -dict {PACKAGE_PIN F14 IOSTANDARD LVCMOS33} [get_ports {clk}]
set_property CLOCK_DEDICATED_ROUTE FALSE [get_nets clk_IBUF]

# Set Bank 0 voltage
set_property CFGBVS VCCO [current_design]
set_property CONFIG_VOLTAGE 3.3 [current_design]

# On-board Slide Switches

set_property -dict {PACKAGE_PIN V2 IOSTANDARD LVCMOS33} [get_ports {B[0]}]
set_property -dict {PACKAGE_PIN U2 IOSTANDARD LVCMOS33} [get_ports {B[1]}]
set_property -dict {PACKAGE_PIN U1 IOSTANDARD LVCMOS33} [get_ports {B[2]}]
set_property -dict {PACKAGE_PIN T2 IOSTANDARD LVCMOS33} [get_ports {B[3]}]
set_property -dict {PACKAGE_PIN T1 IOSTANDARD LVCMOS33} [get_ports {A[0]}]
set_property -dict {PACKAGE_PIN R2 IOSTANDARD LVCMOS33} [get_ports {A[1]}]
set_property -dict {PACKAGE_PIN R1 IOSTANDARD LVCMOS33} [get_ports {A[2]}]
set_property -dict {PACKAGE_PIN P2 IOSTANDARD LVCMOS33} [get_ports {A[3]}]
set_property -dict {PACKAGE_PIN P1 IOSTANDARD LVCMOS33} [get_ports {C0}]


# On-board LEDs
set_property -dict {PACKAGE_PIN G1 IOSTANDARD LVCMOS33} [get_ports {S[0]}]
set_property -dict {PACKAGE_PIN G2 IOSTANDARD LVCMOS33} [get_ports {S[1]}]
set_property -dict {PACKAGE_PIN F1 IOSTANDARD LVCMOS33} [get_ports {S[2]}]
set_property -dict {PACKAGE_PIN F2 IOSTANDARD LVCMOS33} [get_ports {S[3]}]

set_property -dict {PACKAGE_PIN E1 IOSTANDARD LVCMOS33} [get_ports {Cout}]

#set_property -dict {PACKAGE_PIN E2 IOSTANDARD LVCMOS33} [get_ports {Z[5]}]
set_property -dict {PACKAGE_PIN E3 IOSTANDARD LVCMOS33} [get_ports {C0_after}]

#set_property -dict {PACKAGE_PIN E5 IOSTANDARD LVCMOS33} [get_ports {Z[7]}]

set_property -dict {PACKAGE_PIN E6 IOSTANDARD LVCMOS33} [get_ports {B_after[0]}]
set_property -dict {PACKAGE_PIN C3 IOSTANDARD LVCMOS33} [get_ports {B_after[1]}]
set_property -dict {PACKAGE_PIN B2 IOSTANDARD LVCMOS33} [get_ports {B_after[2]}]
set_property -dict {PACKAGE_PIN A2 IOSTANDARD LVCMOS33} [get_ports {B_after[3]}]

set_property -dict {PACKAGE_PIN B3 IOSTANDARD LVCMOS33} [get_ports {A_after[0]}]
set_property -dict {PACKAGE_PIN A3 IOSTANDARD LVCMOS33} [get_ports {A_after[1]}]
set_property -dict {PACKAGE_PIN B4 IOSTANDARD LVCMOS33} [get_ports {A_after[2]}]
set_property -dict {PACKAGE_PIN A4 IOSTANDARD LVCMOS33} [get_ports {A_after[3]}]

# On-board Buttons
set_property -dict {PACKAGE_PIN H2 IOSTANDARD LVCMOS33} [get_ports {reset}]
set_property -dict {PACKAGE_PIN J1 IOSTANDARD LVCMOS33} [get_ports {clk}]
